ivanKIP/MC_ATtiny13_extract_fan/README.md

# MK-tiny13-extract-fan

Вытяжка для ванной/туалета с таймером на базе микроконтроллера ATtiny13A

В данном проекте используется внутренний RC-генератор на 9.6 МГц с делителем частоты на 8 (результирующая частота 1.2 МГц). Watchdog управляется из кода.
Для этого установлены следующие Fuse bits:

> - Low Fuse  : `0x6A`
> - High Fuse : `0xFF`
