ivanKIP/MC_ATtiny13_extract_fan/DipTrace Schematic - Схема.pdf

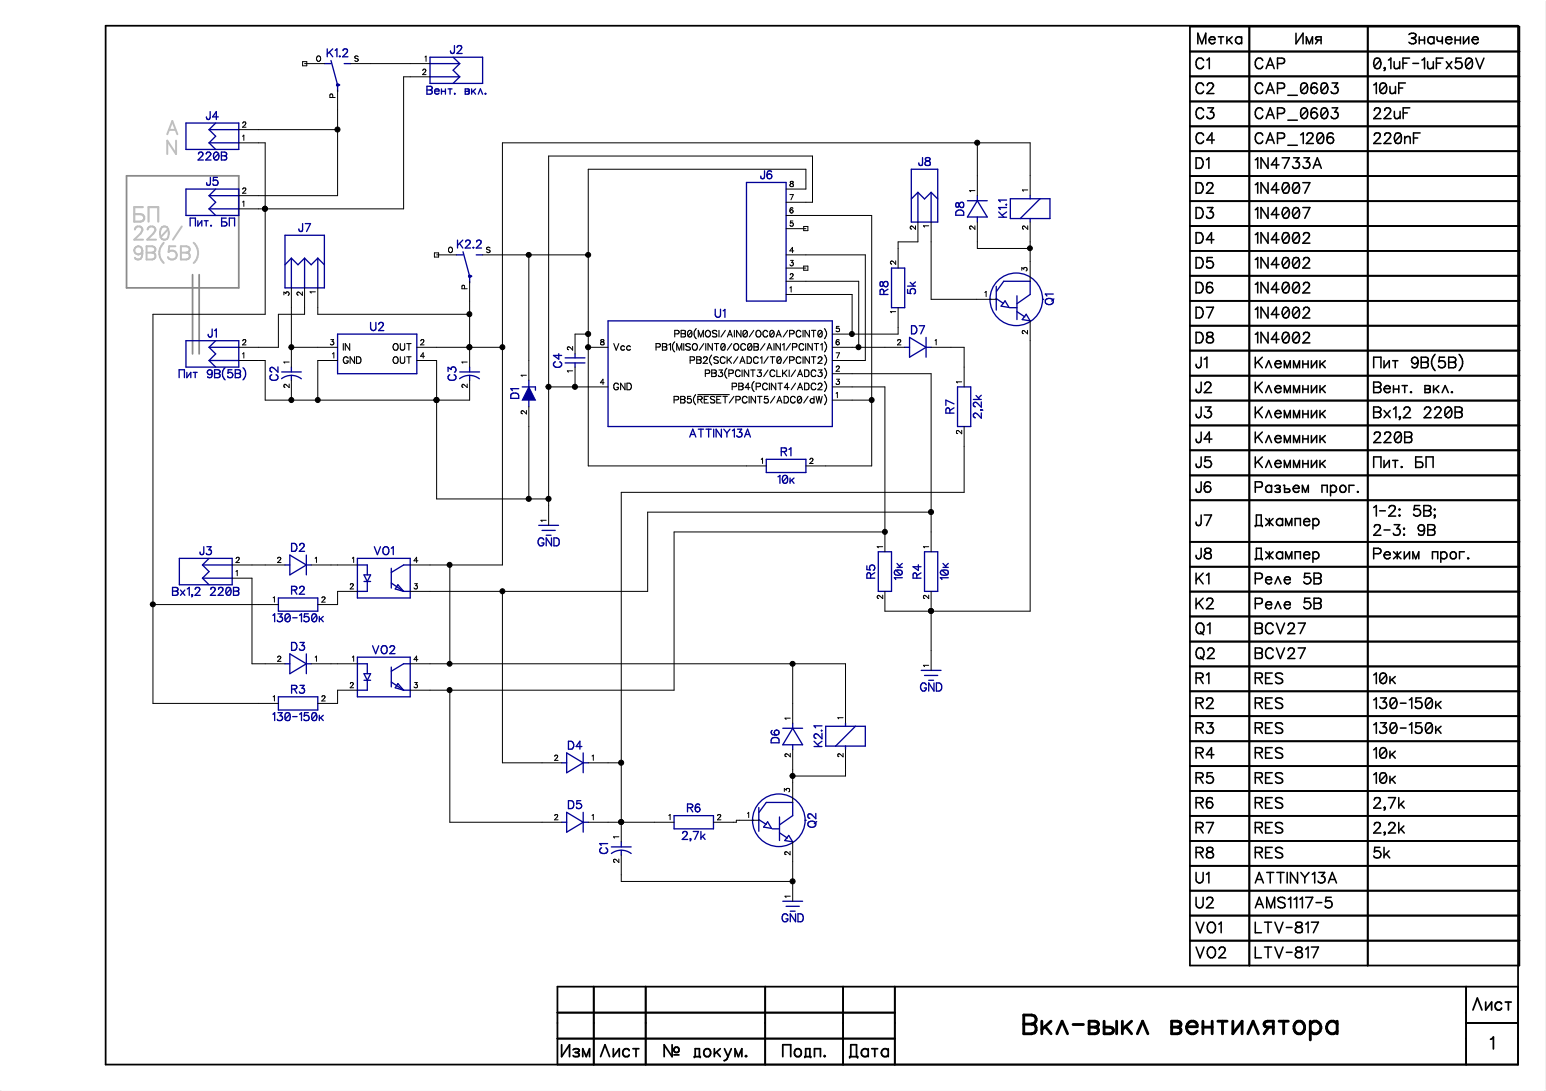
[picture p1: page 1]
