ivanKIP/MC_ATtiny13_extract_fan/DipTrace PCB - Плата.pdf

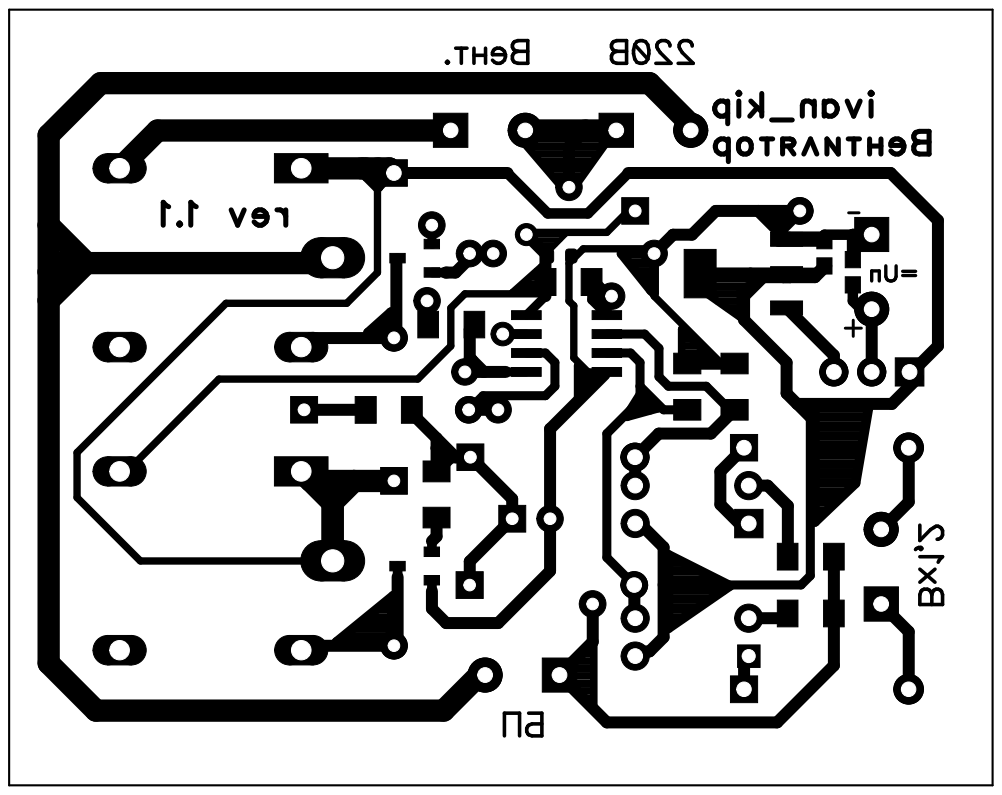
[picture p2: page 1]
