ivanKIP/MC_ATtiny13_extract_fan/(list of files, drawings)

Other design files:
Плата.dip
Схема.dch
