ivanKIP/MC_ATtiny13_extract_fan/(commit log)

2018-10-09 Базовое приложение (конфигурация)
    [vent.cfg]
2018-10-09 Дополнен список игнорирования
2018-10-09 Схема проекта в DipTrace
    [Схема.dch]
2018-10-09 Плата проекта в DipTrace
    [Плата.dip]
2018-10-09 Добавлена заливка на плате
    [Плата.dip]
2018-10-10 Схема в формате PDF
2018-10-10 Плата в формате PDF
2018-10-10 Дополнен список игнорирования
    Удалены лишние файлы
    [vent.cfg]
2018-10-19 Удалены лишние (устаревшие) файлы
    Дополнен список игнорирования
2018-10-19 Проект для AvrStudio4 (debugger)
2018-10-19 Первое рабочее приложение
2018-10-24 Рабочий проект с комментариями
2018-11-02 Плата в формате PDF
    Поправлена разводка AMS1117
2018-11-02 Плата проекта в DipTrace
    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
    [Плата.dip]
2018-11-21 Добавлены разные задержки на включение
    На каждый вход своя уставка времени задержки
2019-04-03 Обновлена схема
    Добавлен джампер выбора напряжения, реле K2 включает только МК
    [Схема.dch]
2019-04-03 Обновлена плата
    Плата приведена в соответствие со схемой
    [Плата.dip]
2019-04-03 Доработана программа
    Изменены уставки по времени, убрано засыпание МК
2019-04-18 Доработана программа
    Вкл. света в ванной после туалета не увеличивает сразу время работы вентилятора
2019-10-02 Обновлена схема
    Добавлен джампер режима работа/программирование
    [Схема.dch]
2019-12-31 Изменены временные уставки
2025-05-06 На схему и плату добавлен конденсатор C4 Для фильтрации помех по питанию
    [Плата.dip, Схема.dch]
2025-05-06 Доработан алгоритм Обновлён алгоритм подсчёта частоты тока на выключателях; добавлен watchdog; нужные переменные объявлены как volatile; избавились от ненужных библиотек; изменены уставки; правки для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
